marmontm/Arduino-AutomatedLightSys/images/overview1.jpg

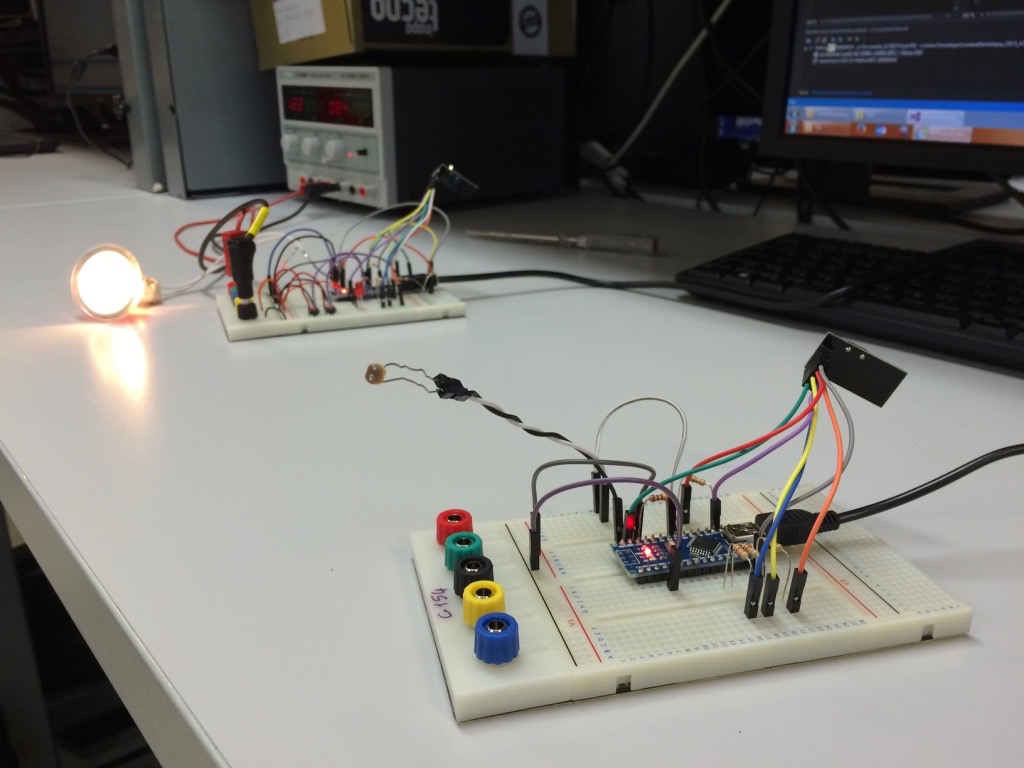
images/overview1.jpg
