marmontm/Arduino-AutomatedLightSys/images/overview2.jpg

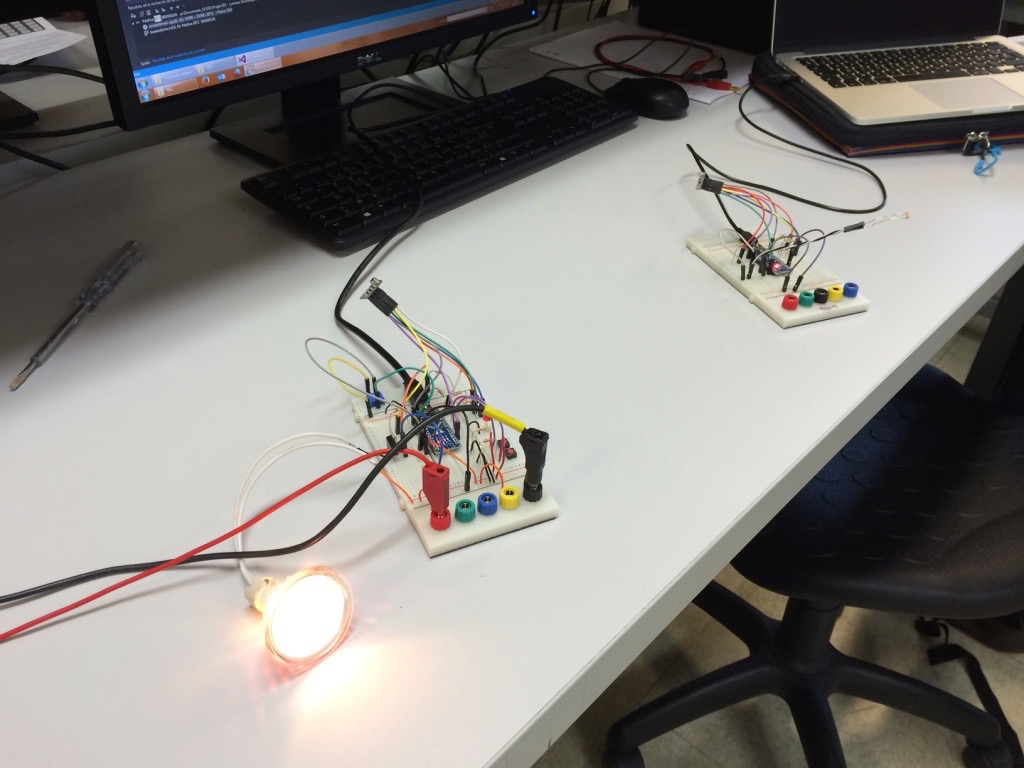
images/overview2.jpg
