marmontm/Arduino-AutomatedLightSys/documents/Drawing_en.pdf

## Simplified overview

Wired connection

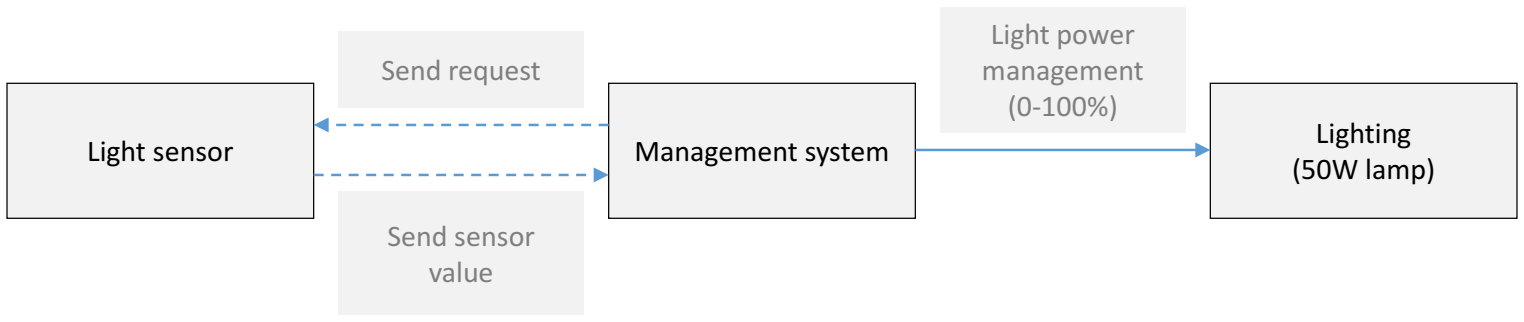
[picture p5: figure]
Light power management (0-100%); Light sensor; Lighting; (50W lamp) Management system; Send sensor value; Send request

Wireless connection

## Functional scheme of the whole system

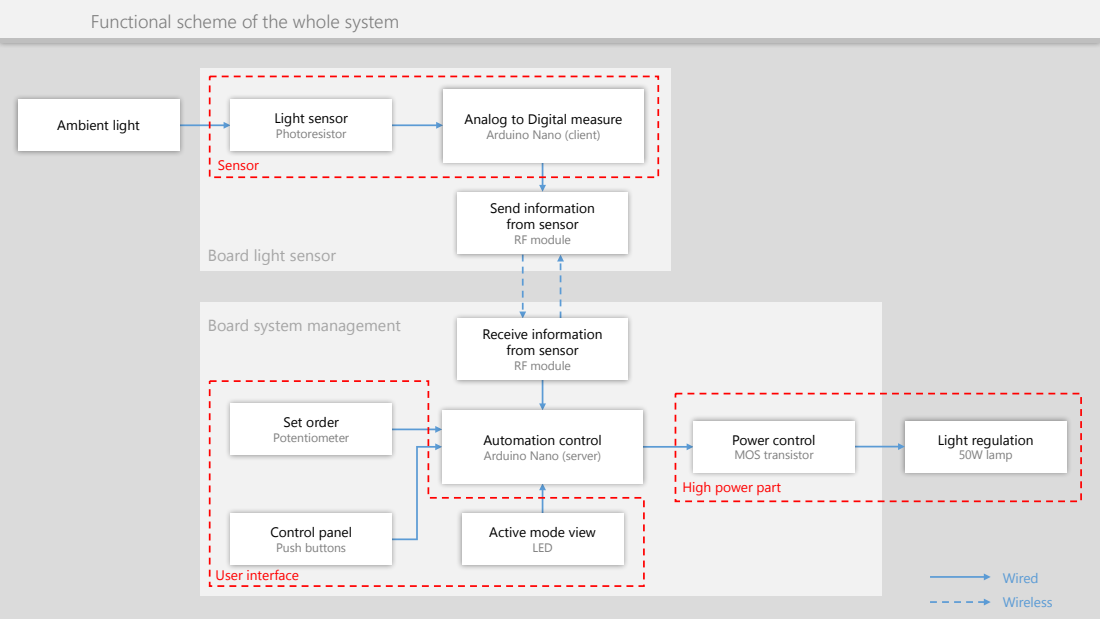
[picture p6: page 2]
Light regulation 50W lamp; Ambient light; Light sensor; Photoresistor; Send information from sensor RF module; Receive information from sensor RF module; Set order Potentiometer; Sensor; User interface; Control panel Push buttons; Wired Wireless

Analog to Digital measure
Arduino Nano (client)

Board light sensor

Board system management

Automation control
Arduino Nano (server)

Power control
MOS transistor
High power part

Active mode view
LED

## Mode management

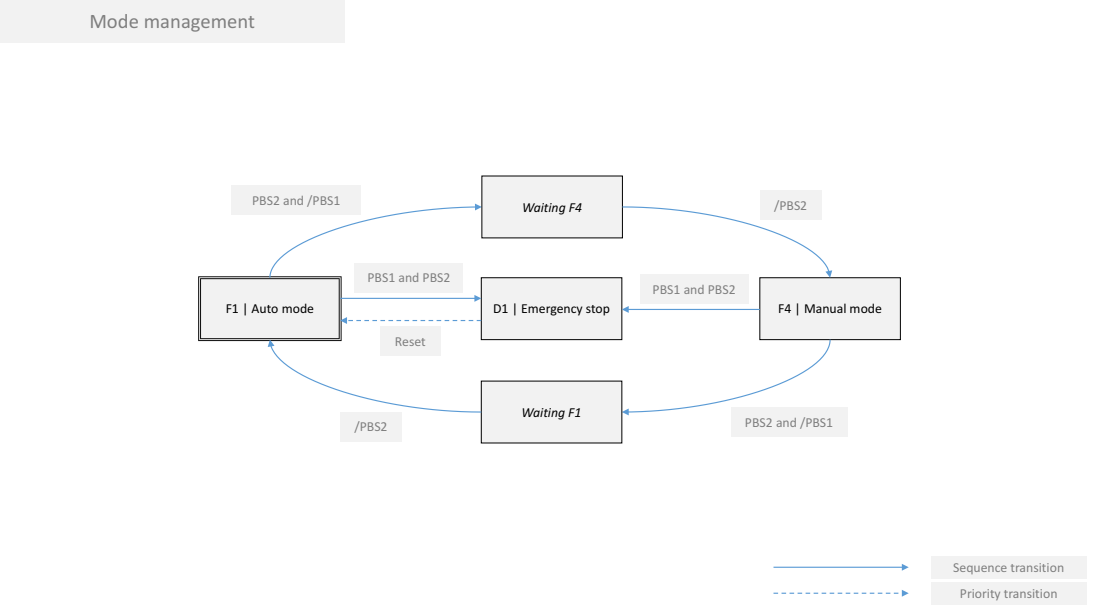
[picture p7: page 3]
Sequence transition; Priority transition; F1 | Auto mode; D1 | Emergency stop; F4 | Manual mode; PBS2 and /PBS1; Waiting F4; Waiting F1; /PBS2; PBS1 and PBS2; Reset

## F4 | Manual mode

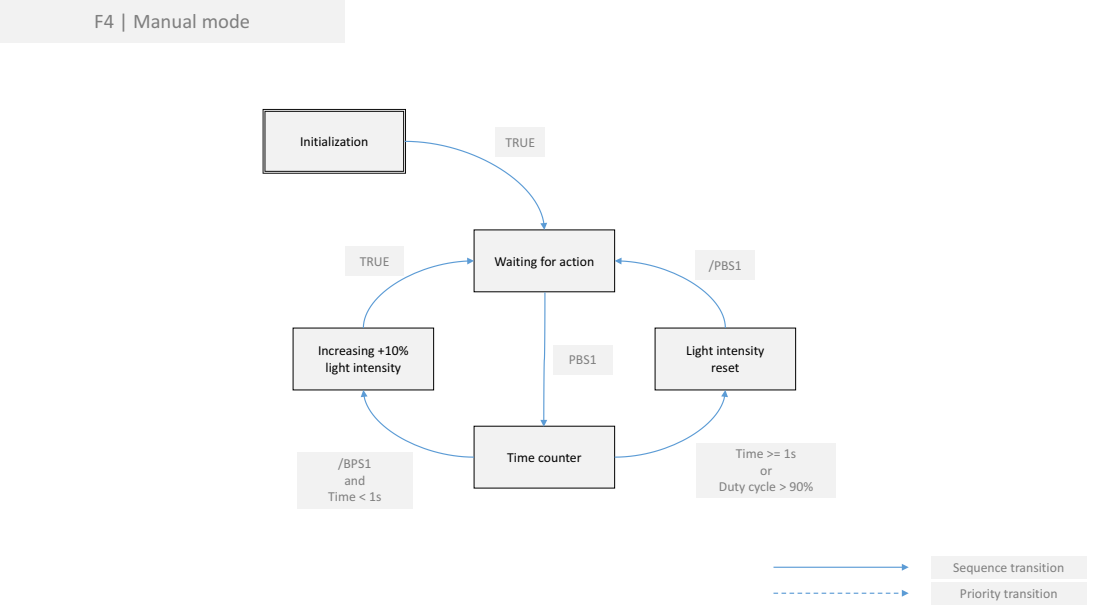
[picture p8: page 4]
Initialization; TRUE; Time counter; Light intensity reset; Increasing +10% light intensity; /PBS1; Time >= 1s or Duty cycle > 90%; /BPS1 and Time < 1s; PBS1; Sequence transition; Priority transition

Waiting for action

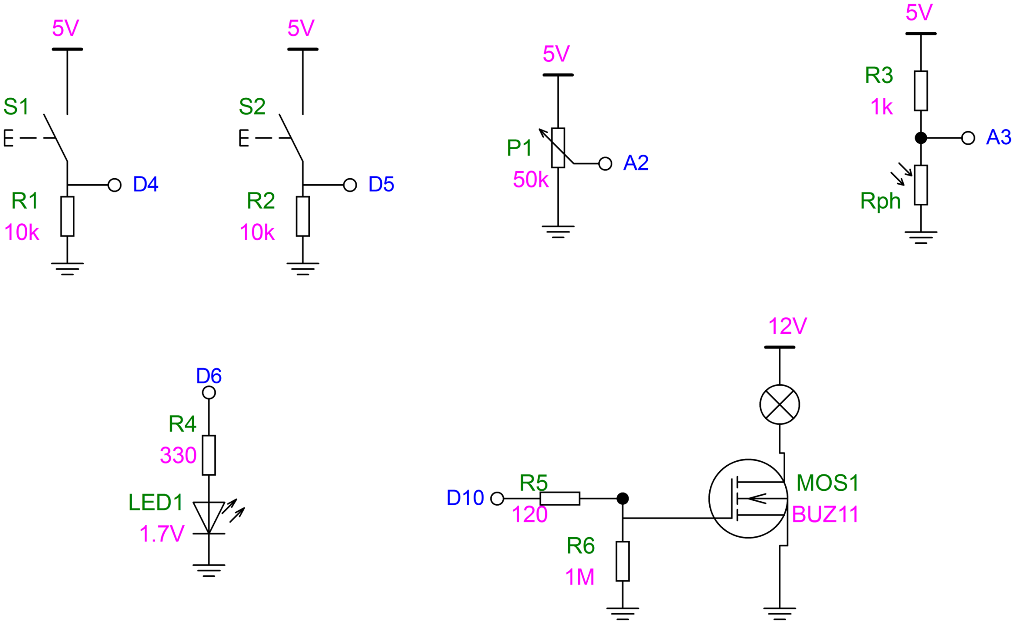
[picture p9: page 5]
