marmontm/Arduino-AutomatedLightSys/documents/Drawing_fr.pdf

## Vision d’ensemble simpliste

Liaison filaire
Liaison sans fil

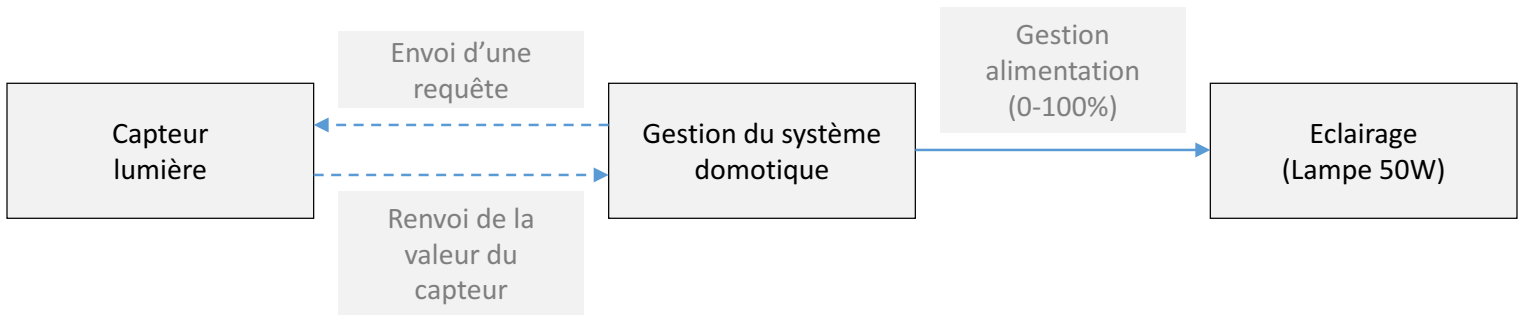
[picture p10: figure]
Gestion alimentation (0-100%); Capteur lumière; Eclairage (Lampe 50W); Gestion du système domotique; Renvoi de la valeur du capteur; Envoi d’une requête

## Schéma fonctionnel global du projet Lumière Domotique

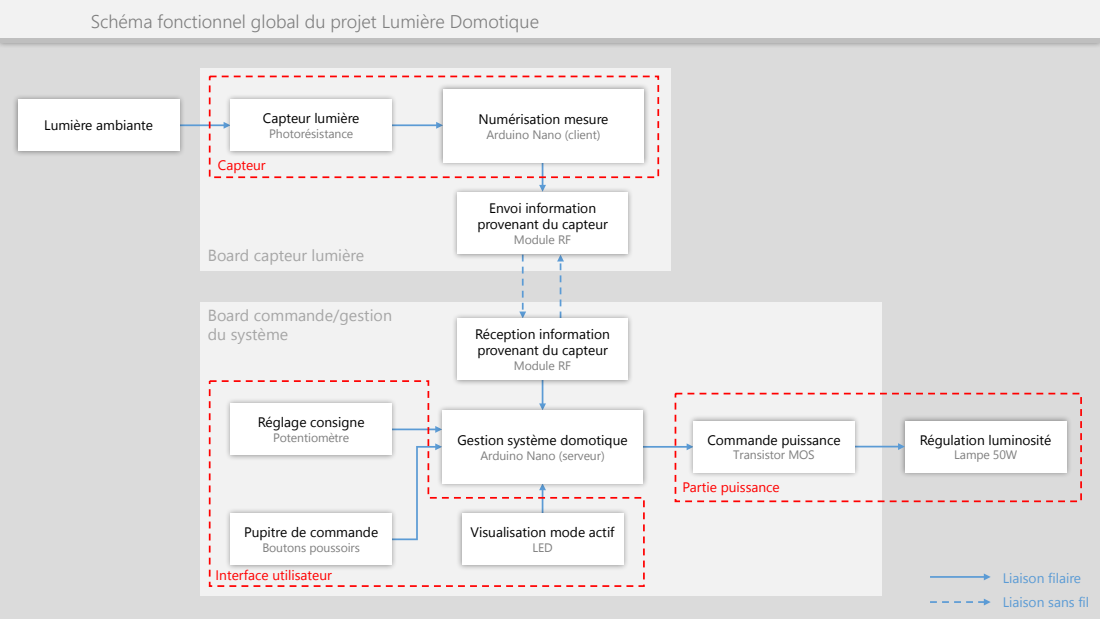
[picture p11: page 2]
Régulation luminosité Lampe 50W; Lumière ambiante; Capteur lumière; Photorésistance; LED; Réglage consigne Potentiomètre; Capteur; Partie puissance; Commande puissance Transistor MOS

Numérisation mesure
Arduino Nano (client)

Envoi information
provenant du capteur
Module RF

Board capteur lumière

Board commande/gestion
du système

Réception information

Gestion système domotique
Arduino Nano (serveur)

Pupitre de commande
Boutons poussoirs
Interface utilisateur

Visualisation mode actif

Liaison filaire
Liaison sans fil

## Gemma

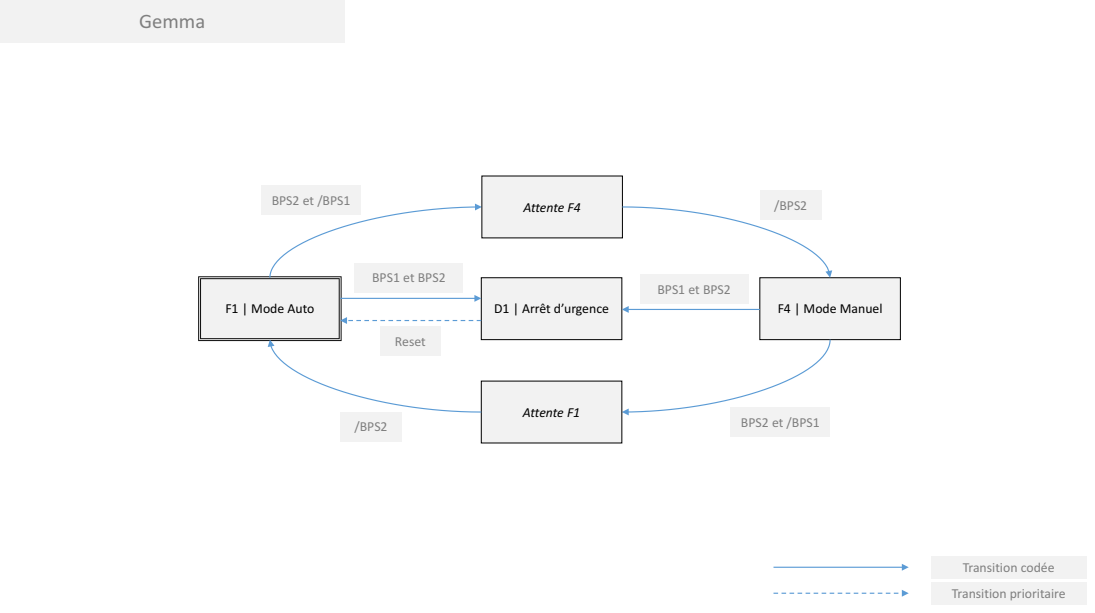
[picture p12: page 3]
Transition codée; Transition prioritaire; F1 | Mode Auto; D1 | Arrêt d’urgence; F4 | Mode Manuel; BPS2 et /BPS1; Attente F4; Attente F1; /BPS2; BPS1 et BPS2; Reset

## F4 | Mode manuel

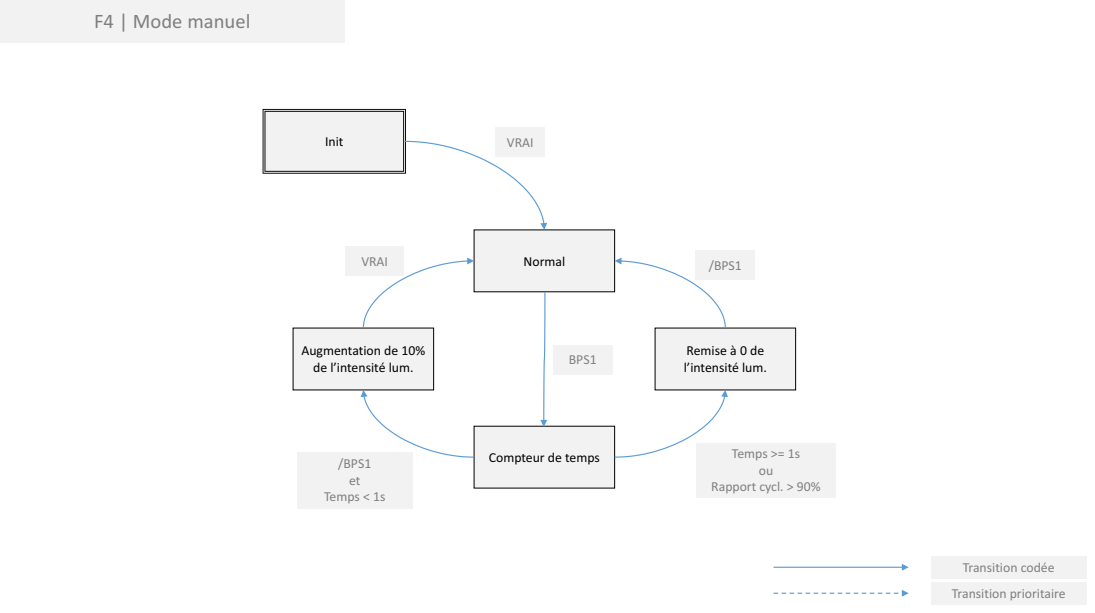
[picture p13: page 4]
Transition codée; Transition prioritaire; Init; VRAI; Normal; Remise à 0 de l’intensité lum.; /BPS1; Temps >= 1s ou Rapport cycl. > 90%; /BPS1 et Temps < 1s; BPS1

Augmentation de 10%
de l’intensité lum.

Compteur de temps
